f-zhuk/PatientMonitor/Electronics/PatientMonitor.csv

Source: | /home/fedorzhuk/Documents/KiCAD/PatientMonitor/PatientMonitor.kicad_sch
Date: | Du 26 mai 2024 01:57:51 +0300
Tool: | Eeschema 7.0.10-7.0.10~ubuntu20.04.1
Generator: | /usr/share/kicad/plugins/bom_csv_grouped_by_value_with_fp.py
Component Count: | 40
Ref | Qnty | Value | Cmp name | Footprint | Description | Vendor | DNP
BZ1 | 1 | Buzzer | Buzzer | Buzzer_Beeper:Buzzer_15x7.5RM7.6 | Buzzer, polarized
C1, C2, C3 | 3 | 10u | C | Capacitor_SMD:C_0805_2012Metric_Pad1.18x1.45mm_HandSolder | Unpolarized capacitor
C4, C5, C6, C7 | 4 | 100n | C | Capacitor_SMD:C_0603_1608Metric_Pad1.08x0.95mm_HandSolder | Unpolarized capacitor
H1, H2, H3, H4 | 4 | MountingHole | MountingHole | MountingHole:MountingHole_3.2mm_M3 | Mounting Hole without connection
J1, J6 | 2 | Conn_01x20 | Conn_01x20 | Connector_PinSocket_2.54mm:PinSocket_1x20_P2.54mm_Vertical | Generic connector, single row, 01x20, script generated (kicad-library-utils/schlib/autogen/connector/)
J2 | 1 | Conn_01x10 | Conn_01x10 | Connector_PinSocket_2.54mm:PinSocket_1x10_P2.54mm_Vertical | Generic connector, single row, 01x10, script generated (kicad-library-utils/schlib/autogen/connector/)
J3 | 1 | Conn_01x14 | Conn_01x14 | Connector_PinSocket_2.54mm:PinSocket_1x14_P2.54mm_Vertical | Generic connector, single row, 01x14, script generated (kicad-library-utils/schlib/autogen/connector/)
J4 | 1 | Conn_01x06 | Conn_01x06 | Connector_PinSocket_2.54mm:PinSocket_1x06_P2.54mm_Vertical | Generic connector, single row, 01x06, script generated (kicad-library-utils/schlib/autogen/connector/)
J5, J10 | 2 | Conn_01x03 | Conn_01x03 | Connector_PinSocket_2.54mm:PinSocket_1x03_P2.54mm_Vertical | Generic connector, single row, 01x03, script generated (kicad-library-utils/schlib/autogen/connector/)
J7, J8, J9 | 3 | Conn_01x01 | Conn_01x01 | Connector_Wire:SolderWire-0.5sqmm_1x01_D0.9mm_OD2.3mm | Generic connector, single row, 01x01, script generated (kicad-library-utils/schlib/autogen/connector/)
J11 | 1 | Conn_01x05 | Conn_01x05 | Connector_PinHeader_2.54mm:PinHeader_1x05_P2.54mm_Vertical | Generic connector, single row, 01x05, script generated (kicad-library-utils/schlib/autogen/connector/)
R1, R2, R3, R4, R7, R8, R12, R13, R14 | 9 | 10k | R | Resistor_SMD:R_0603_1608Metric_Pad0.98x0.95mm_HandSolder | Resistor
R5 | 1 | 2.2k | R | Resistor_SMD:R_0603_1608Metric_Pad0.98x0.95mm_HandSolder | Resistor
R6 | 1 | 68k | R | Resistor_SMD:R_0603_1608Metric_Pad0.98x0.95mm_HandSolder | Resistor
R9, R10 | 2 | 0R | R | Resistor_SMD:R_0603_1608Metric_Pad0.98x0.95mm_HandSolder | Resistor
R11 | 1 | 4.7k | R | Resistor_SMD:R_0603_1608Metric_Pad0.98x0.95mm_HandSolder | Resistor
U1 | 1 | TP4056 | TP4056 | Package_SO:SOIC-8-1EP_3.9x4.9mm_P1.27mm_EP2.29x3mm
U2 | 1 | LM1117DT-3.3 | LM1117DT-3.3 | Package_TO_SOT_SMD:TO-252-2 | 800mA Low-Dropout Linear Regulator, 3.3V fixed output, TO-252
U3 | 1 | 74HC14 | 74HC14 | Package_SO:SO-14_3.9x8.65mm_P1.27mm | Hex inverter schmitt trigger
