f-zhuk/PatientMonitor/Mechanical/Cover-AssemblyBody.stl

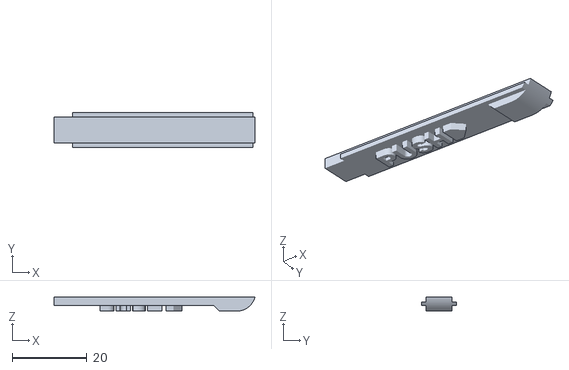
[picture p1: CAD file, 2024-06-10]
Mechanical/Cover-AssemblyBody.stl
53.9 x 9.50 x 3.80
