f-zhuk/PatientMonitor/Mechanical/Top-AssemblyBody.stl

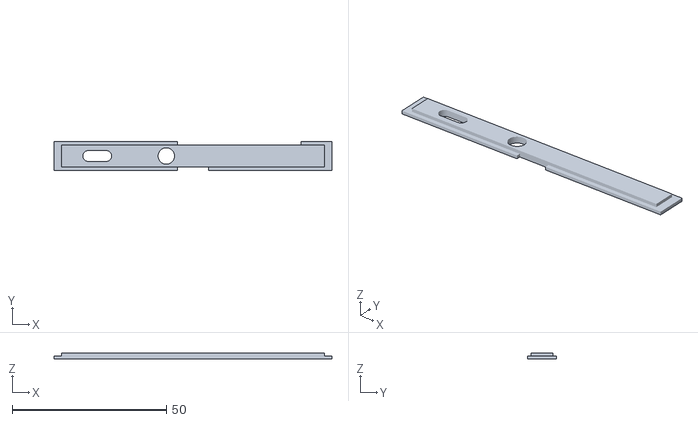
[picture p2: CAD file, 2024-06-10]
Mechanical/Top-AssemblyBody.stl
90.0 x 9.50 x 2.00
