f-zhuk/PatientMonitor/Mechanical/Bottom-AssemblyBody.stl

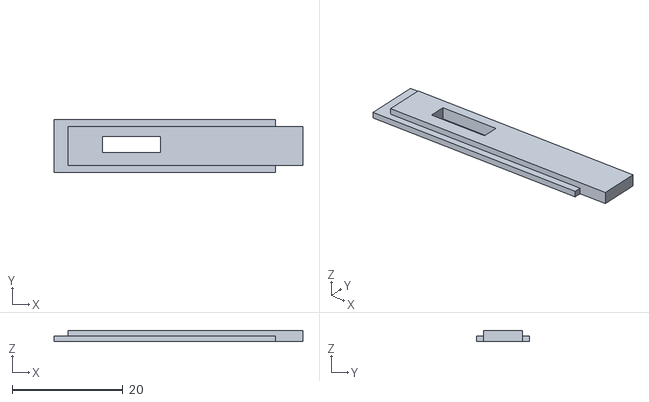
[picture p3: CAD file, 2024-06-10]
Mechanical/Bottom-AssemblyBody.stl
45.0 x 9.50 x 2.00
