f-zhuk/PatientMonitor/Mechanical/Panel_cut.FCStd

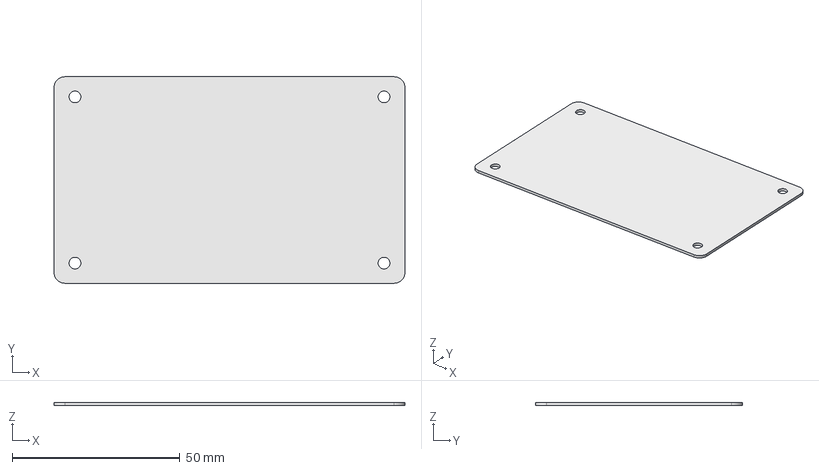
[picture p4: CAD file, 2024-06-10]
Mechanical/Panel_cut.FCStd
104.5 x 61.5 x 1.00 mm
