f-zhuk/PatientMonitor/Mechanical/Compartment-Part.3mf

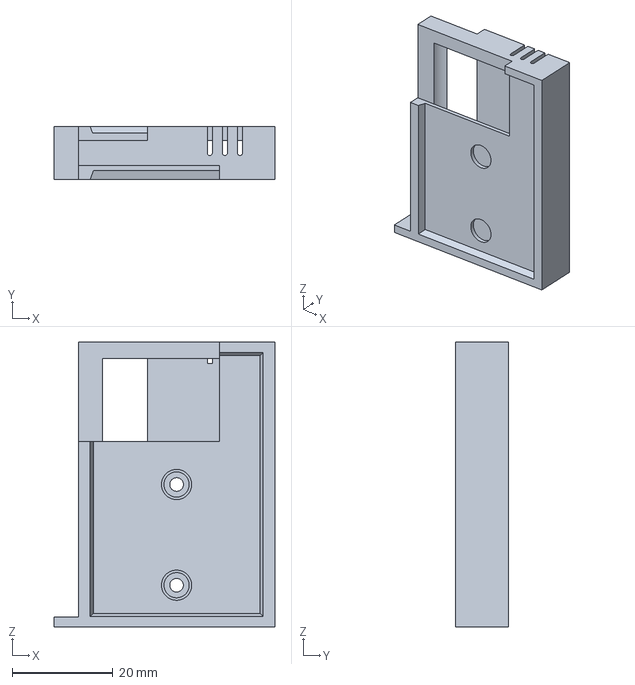
[picture p5: CAD file, 2024-06-10]
Mechanical/Compartment-Part.3mf
43.8 x 10.6 x 56.6 mm
