f-zhuk/PatientMonitor/Mechanical/Front-Front_Part.step

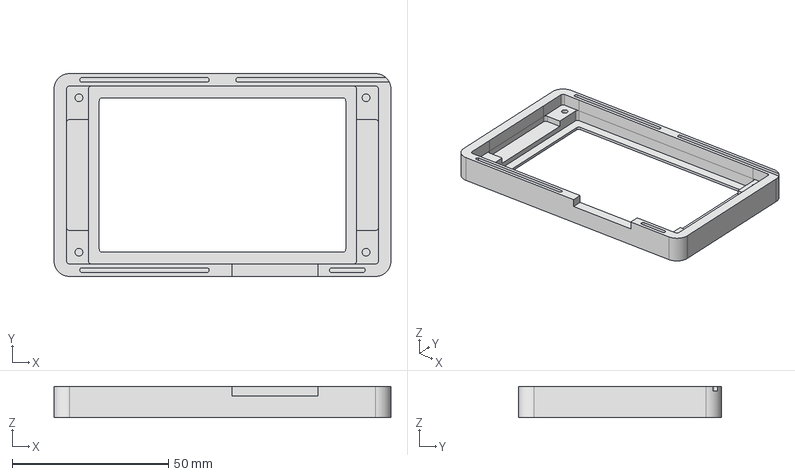
[picture p6: CAD file, 2024-06-10]
Mechanical/Front-Front_Part.step
108.0 x 65.0 x 10.0 mm
LCS_Origin
LCS_Top
LCS_Right
LCS_Cover
LCS_Bottom
