f-zhuk/PatientMonitor/Mechanical/Right-Right_Part.step

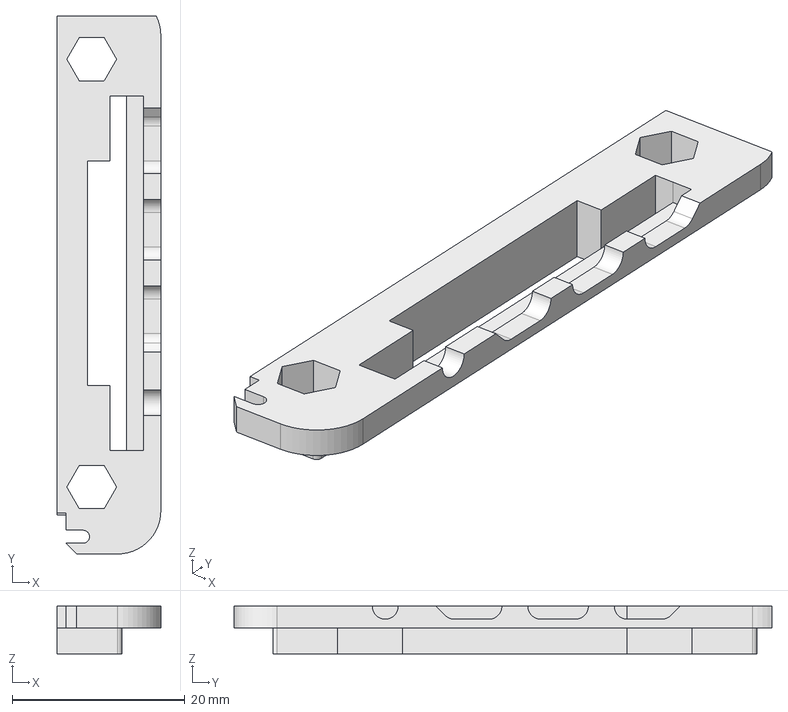
[picture p7: CAD file, 2024-06-10]
Mechanical/Right-Right_Part.step
12.0 x 62.2 x 5.50 mm
LCS_Origin
LCS_Front
