f-zhuk/PatientMonitor/Mechanical/AD8232_offset-AD8232_Part.stl

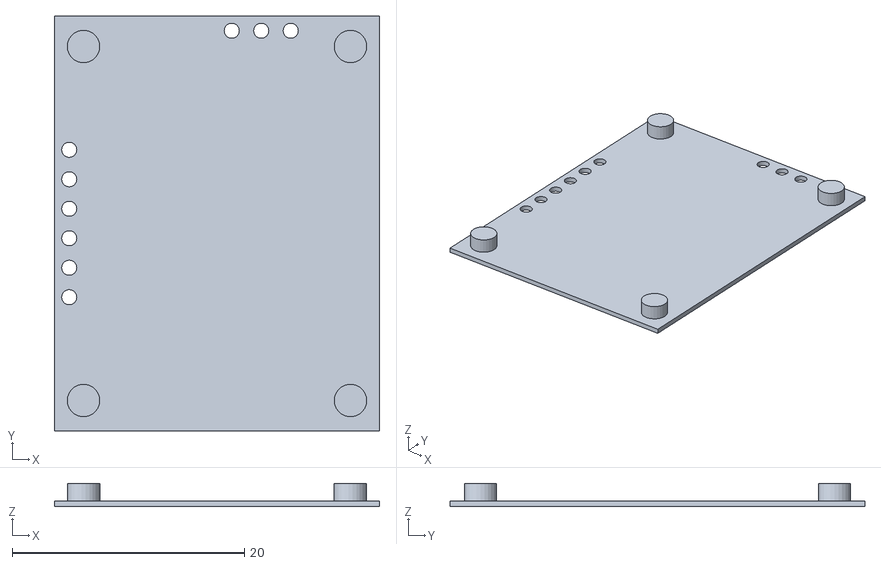
[picture p8: CAD file, 2024-06-10]
Mechanical/AD8232_offset-AD8232_Part.stl
28.0 x 35.8 x 2.00
