f-zhuk/PatientMonitor/Mechanical/BoardTest.FCStd

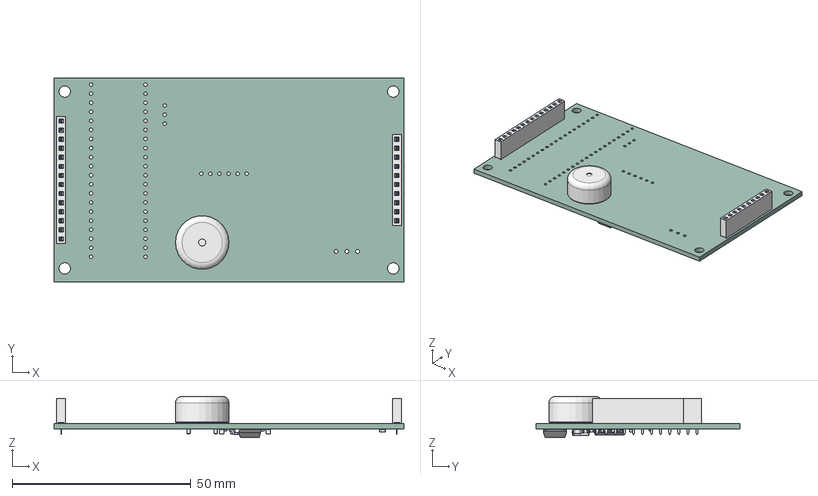
[picture p9: CAD file, 2024-06-10]
Mechanical/BoardTest.FCStd
98.0 x 57.0 x 11.6 mm
PinSocket_1x10_P254mm_Vertical
Buzzer_15x75RM76
PinSocket_1x14_P254mm_Vertical
R_0603_1608Metric
R_0603_1608Metric002
CQ assembly
CQ assembly001
CQ assembly002
CQ assembly003
CQ assembly004
CQ assembly005
CQ assembly006
CQ assembly007
CQ assembly008
CQ assembly009
CQ assembly010
CQ assembly011
CQ assembly012
CQ assembly013
CQ assembly014
CQ assembly015
R_0603_1608Metric004
C_0805_2012Metric
C_0603_1608Metric
R_0603_1608Metric006
C_0603_1608Metric002
SOIC_8_1EP_39x49mm_P127mm
CQ assembly017
CQ assembly018
CQ assembly019
CQ assembly020
CQ assembly021
R_0603_1608Metric008
C_0603_1608Metric004
C_0805_2012Metric002
R_0603_1608Metric010
R_0603_1608Metric012
C_0603_1608Metric006
C_0805_2012Metric004
R_0603_1608Metric014
PatientMonitor PCB
