f-zhuk/PatientMonitor/Mechanical/AD8232.FCStd

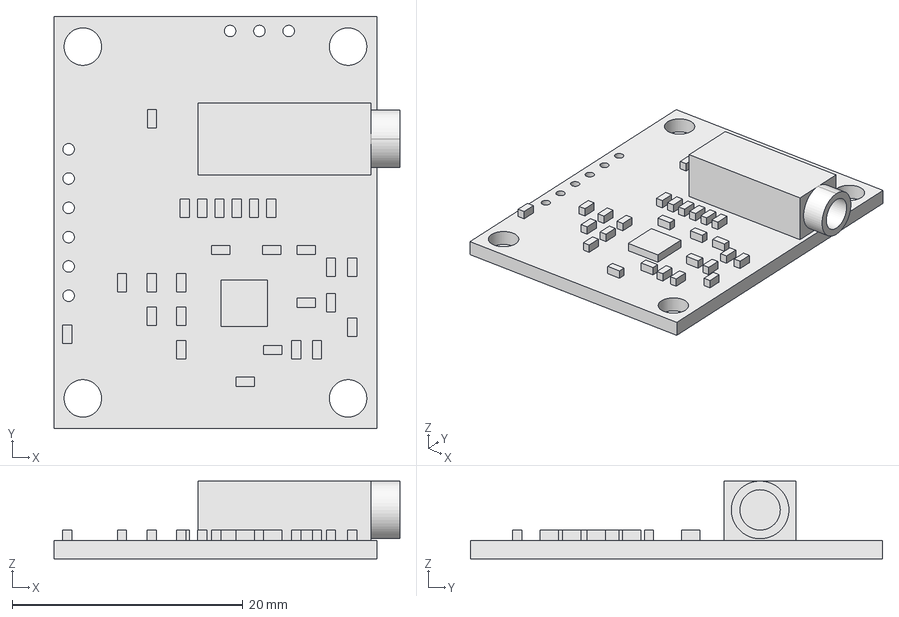
[picture p10: CAD file, 2024-06-10]
Mechanical/AD8232.FCStd
30.0 x 35.8 x 6.75 mm
