f-zhuk/PatientMonitor/Mechanical/FeetMold-Body.step

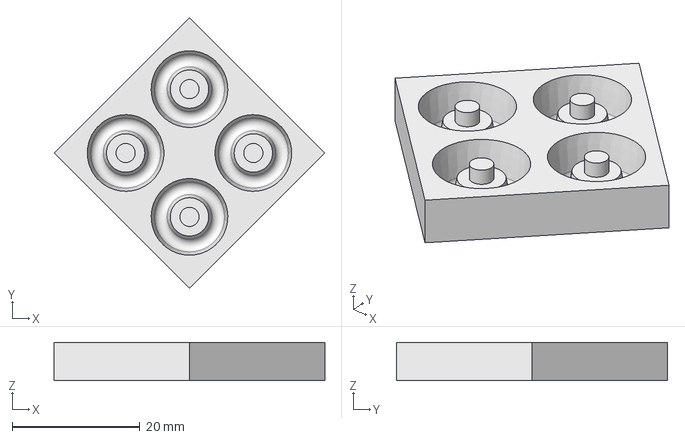
[picture p11: CAD file, 2024-06-10]
Mechanical/FeetMold-Body.step
42.4 x 42.4 x 6.00 mm
