f-zhuk/PatientMonitor/Mechanical/BLACKPILL.FCStd

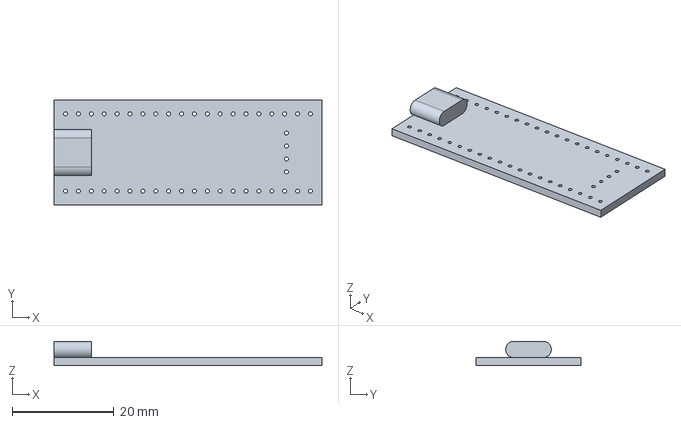
[picture p12: CAD file, 2024-06-10]
Mechanical/BLACKPILL.FCStd
52.8 x 20.8 x 4.80 mm
