f-zhuk/PatientMonitor/Mechanical/ButtonMold-Body2.step

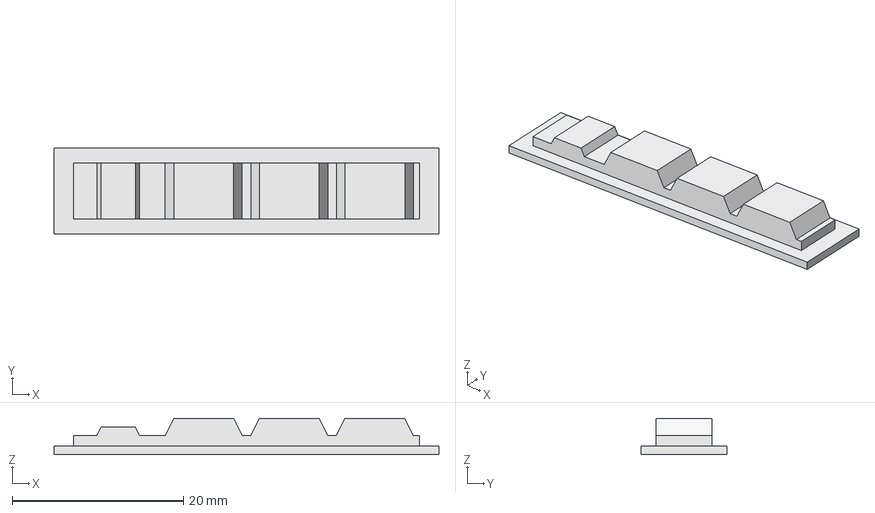
[picture p13: CAD file, 2024-06-10]
Mechanical/ButtonMold-Body2.step
45.0 x 10.0 x 4.25 mm
