f-zhuk/PatientMonitor/Mechanical/Back-Part.stl

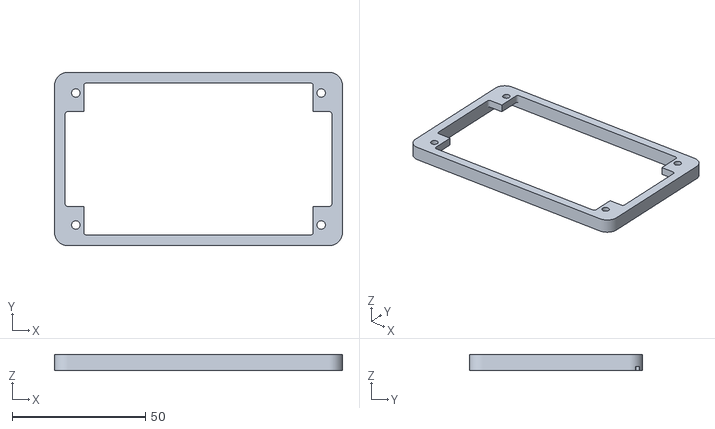
[picture p14: CAD file, 2024-06-10]
Mechanical/Back-Part.stl
108.0 x 65.0 x 6.00
