f-zhuk/PatientMonitor/Mechanical/Bezel.FCStd

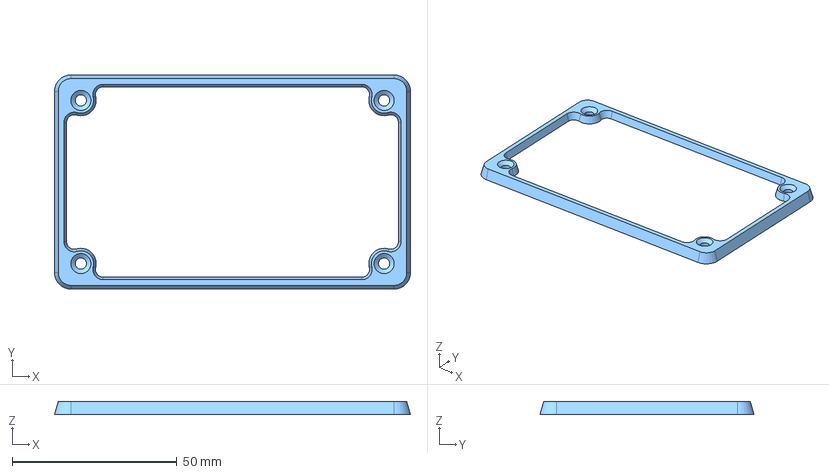
[picture p15: CAD file, 2024-06-10]
Mechanical/Bezel.FCStd
108.0 x 65.0 x 4.00 mm
