f-zhuk/PatientMonitor/Mechanical/ILI9488-Body.step

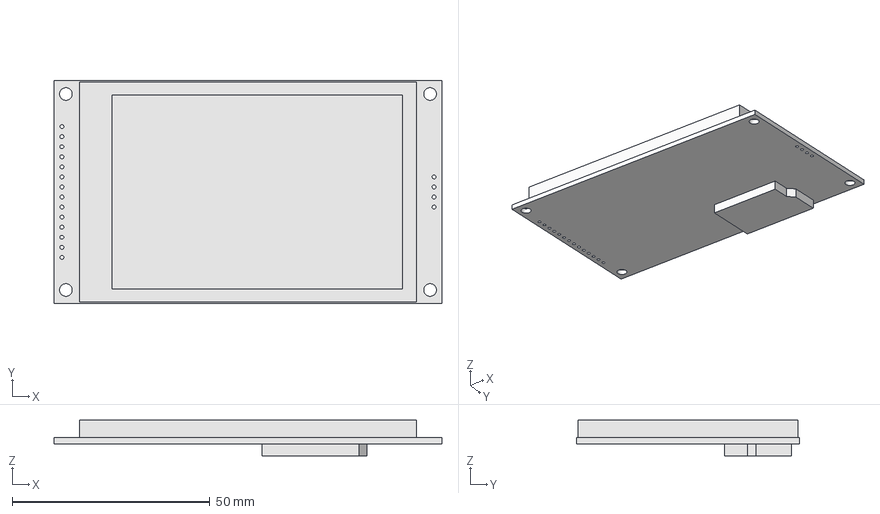
[picture p16: CAD file, 2024-06-10]
Mechanical/ILI9488-Body.step
98.0 x 56.3 x 9.00 mm
