f-zhuk/PatientMonitor/Mechanical/Right-Right_PartBody.step

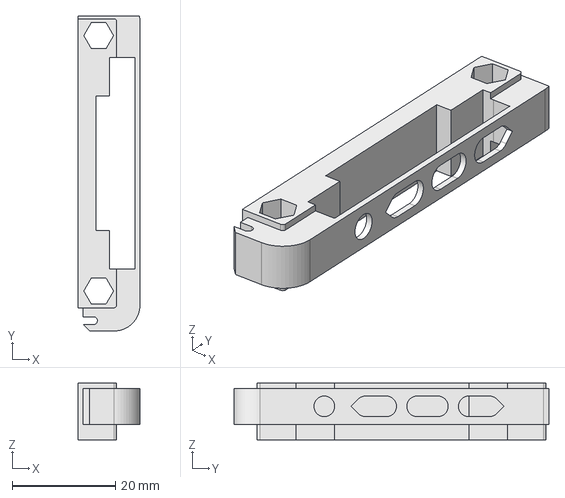
[picture p17: CAD file, 2024-06-10]
Mechanical/Right-Right_PartBody.step
12.0 x 61.0 x 11.0 mm
