f-zhuk/PatientMonitor/Mechanical/Cover-Cover_Part.step

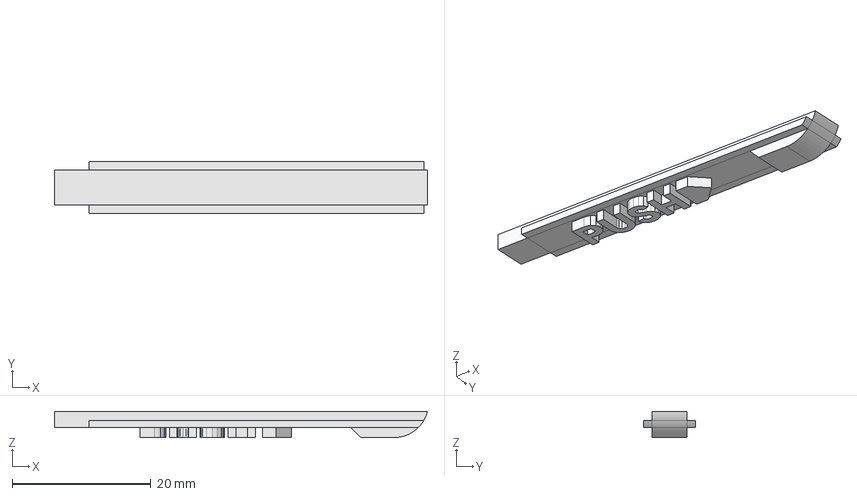
[picture p18: CAD file, 2024-06-10]
Mechanical/Cover-Cover_Part.step
53.9 x 7.50 x 3.80 mm
LCS_Origin
LCS_Front
