f-zhuk/PatientMonitor/Mechanical/Left_copart-Part.step

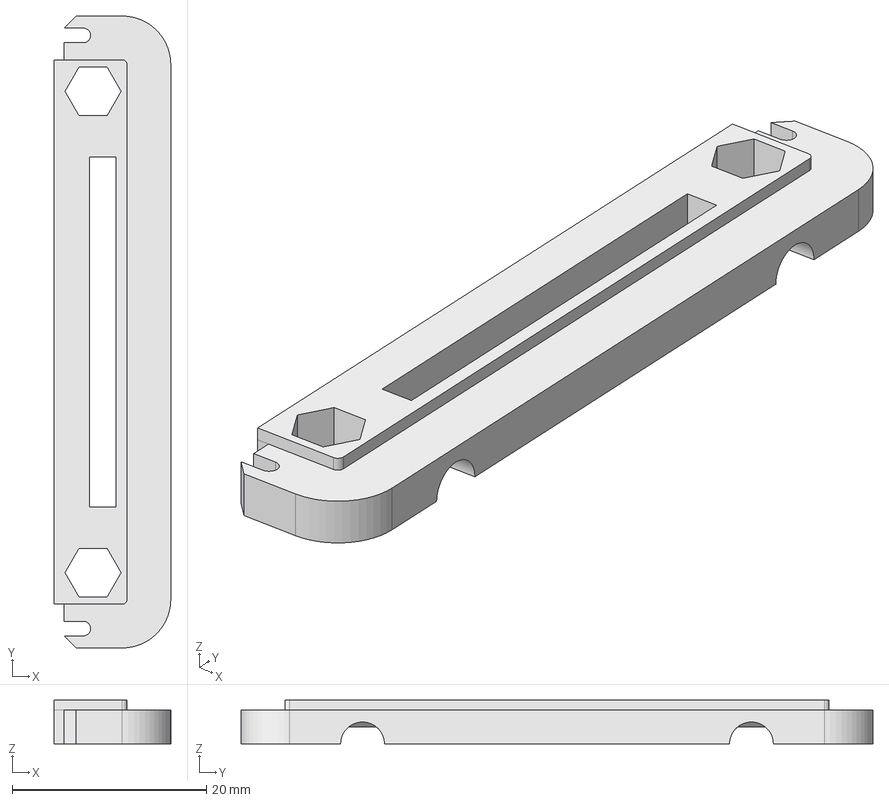
[picture p19: CAD file, 2024-06-10]
Mechanical/Left_copart-Part.step
12.0 x 65.0 x 4.50 mm
LCS_Origin
LCS_Front
