f-zhuk/PatientMonitor/Mechanical/Buzzer-Body.step

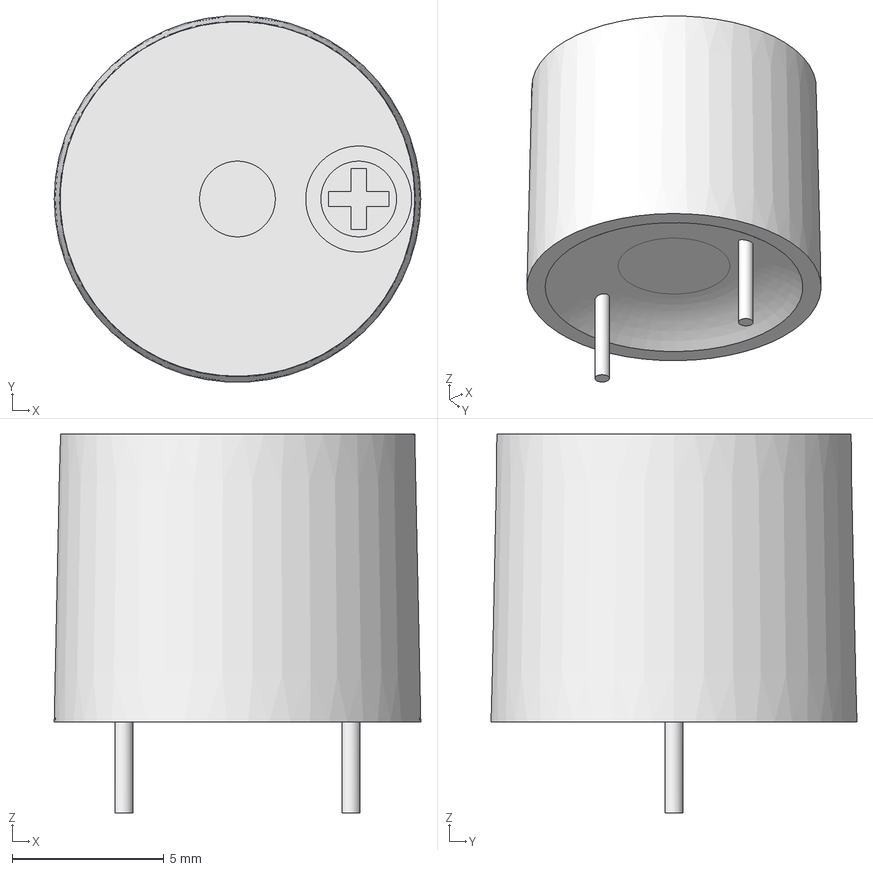
[picture p20: CAD file, 2024-06-10]
Mechanical/Buzzer-Body.step
12.1 x 12.1 x 12.5 mm
