f-zhuk/PatientMonitor/Mechanical/BL-4C.FCStd

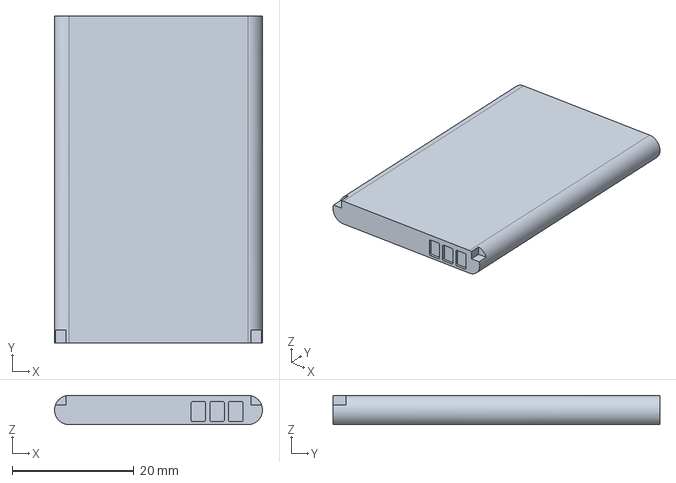
[picture p21: CAD file, 2024-06-10]
Mechanical/BL-4C.FCStd
34.1 x 53.6 x 4.80 mm
