f-zhuk/PatientMonitor/Mechanical/Left.FCStd

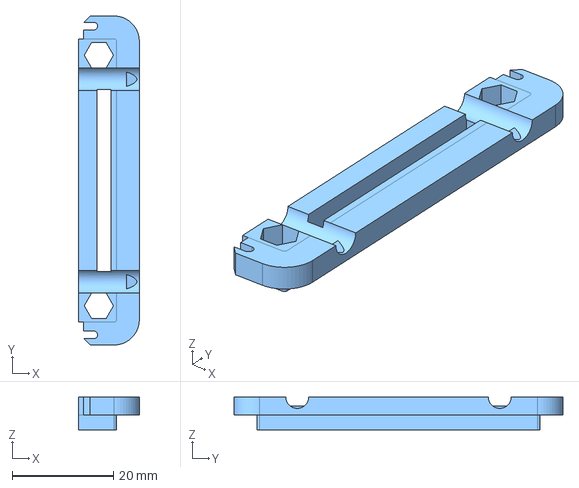
[picture p22: CAD file, 2024-06-10]
Mechanical/Left.FCStd
12.0 x 65.0 x 6.50 mm
