f-zhuk/PatientMonitor/Mechanical/ButtonMold.FCStd

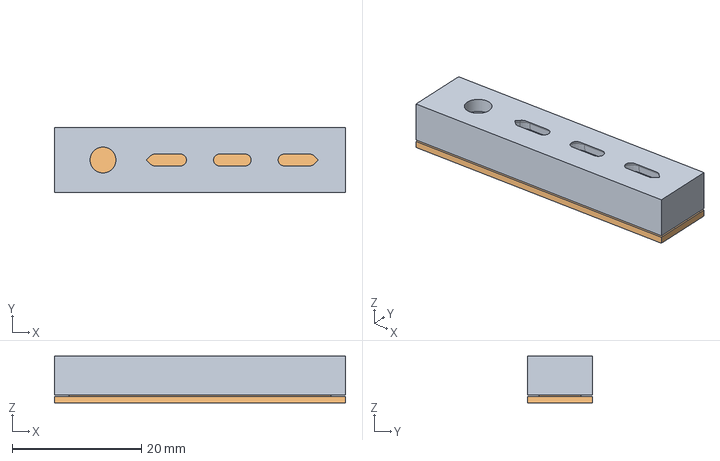
[picture p23: CAD file, 2024-06-10]
Mechanical/ButtonMold.FCStd
45.0 x 10.0 x 7.25 mm
