f-zhuk/PatientMonitor/Mechanical/PatientMonitor.FCStd

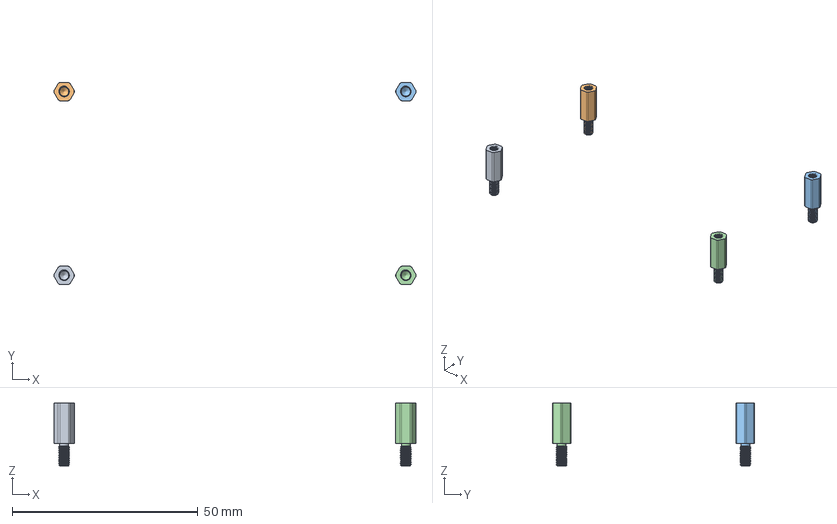
[picture p24: CAD file, 2024-06-10]
Mechanical/PatientMonitor.FCStd
97.5 x 54.5 x 16.9 mm
M3x11xx5-Standoff
M3x11xx5-Standoff013
M3x11xx5-Standoff014
M3x11xx5-Standoff015
