f-zhuk/PatientMonitor/Mechanical/PLS.FCStd

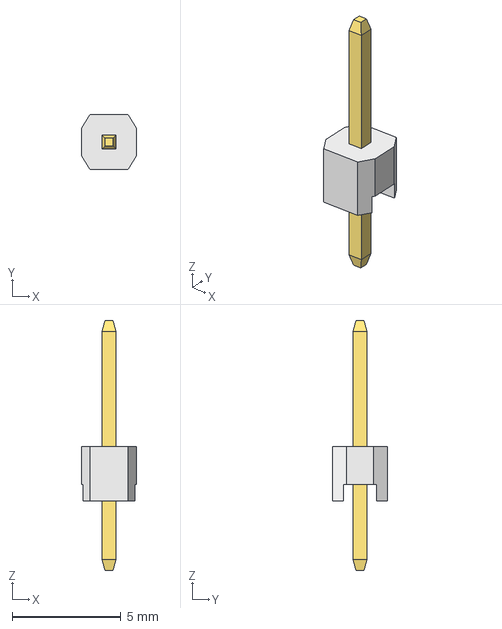
[picture p25: CAD file, 2024-06-10]
Mechanical/PLS.FCStd
2.54 x 2.54 x 11.5 mm
Pin
Skirt
