f-zhuk/PatientMonitor/Mechanical/ButtonMold-Body.step

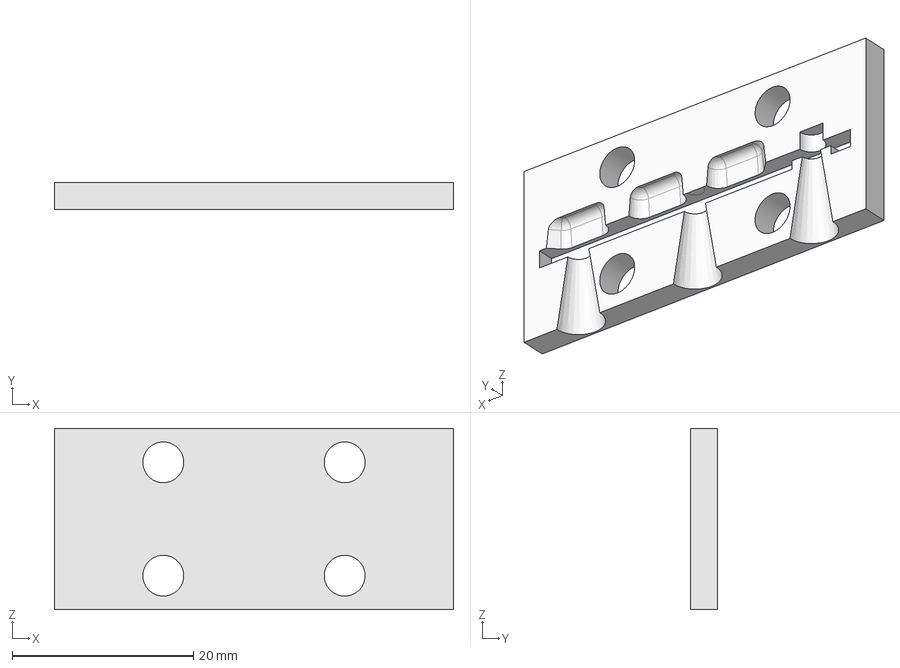
[picture p26: CAD file, 2024-06-10]
Mechanical/ButtonMold-Body.step
44.0 x 3.00 x 20.0 mm
