f-zhuk/PatientMonitor/Mechanical/TSW-101-07-G-S.stp

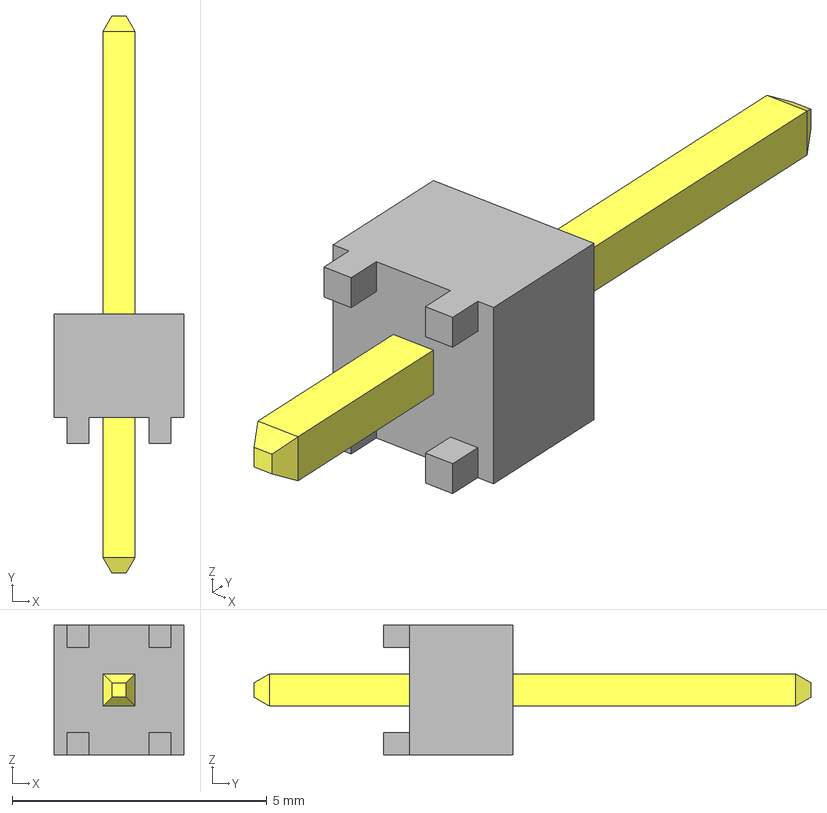
[picture p27: CAD file, 2024-06-10]
Mechanical/TSW-101-07-G-S.stp
2.54 x 10.9 x 2.54 mm
TSW-101-07-G-S_body
T-1S6-07-TSW-1-07-1-S
