f-zhuk/PatientMonitor/Mechanical/BLACKPILL_offset.FCStd

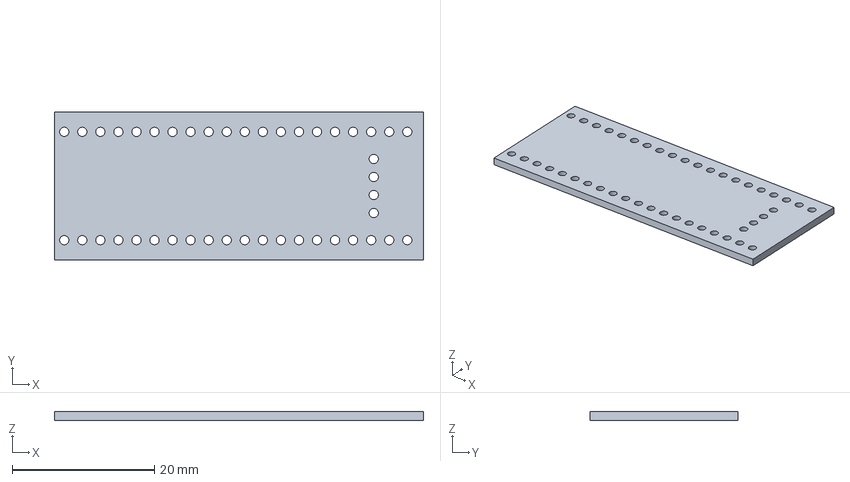
[picture p28: CAD file, 2024-06-10]
Mechanical/BLACKPILL_offset.FCStd
51.9 x 20.8 x 1.20 mm
