f-zhuk/PatientMonitor/(list of files, cad)

Other CAD files:
Mechanical/FeetMold-BodySketch.step
Mechanical/Panel.FCStd
Mechanical/Cover.FCStd
Mechanical/Bottom.FCStd
Mechanical/Back_cut.FCStd
Mechanical/Top.FCStd
Mechanical/Front_cut.FCStd
Mechanical/FeetMold.FCStd
Mechanical/Front.FCStd
Mechanical/AD8232_offset.FCStd
Mechanical/Bezel-Part.stl
Mechanical/Back.FCStd
Mechanical/Buzzer.FCStd
Mechanical/AD8232-Body.step
Mechanical/Right.FCStd
Mechanical/Left-Part.step
Mechanical/Compartment.FCStd
Mechanical/Left_copart.FCStd
Mechanical/Bezel-PartSketch.step
Mechanical/ILI9488.FCStd
Mechanical/AD8232-Body.stl
Mechanical/Bezel-PartSketch.stl
Mechanical/Compartment-Part.stl
Mechanical/Front-Front_Part.stl
Mechanical/ILI9488-Body.stl
Mechanical/Left-Part.stl
Mechanical/Left_copart-Part.stl
