f-zhuk/PatientMonitor/Electronics/PatientMonitor.pdf

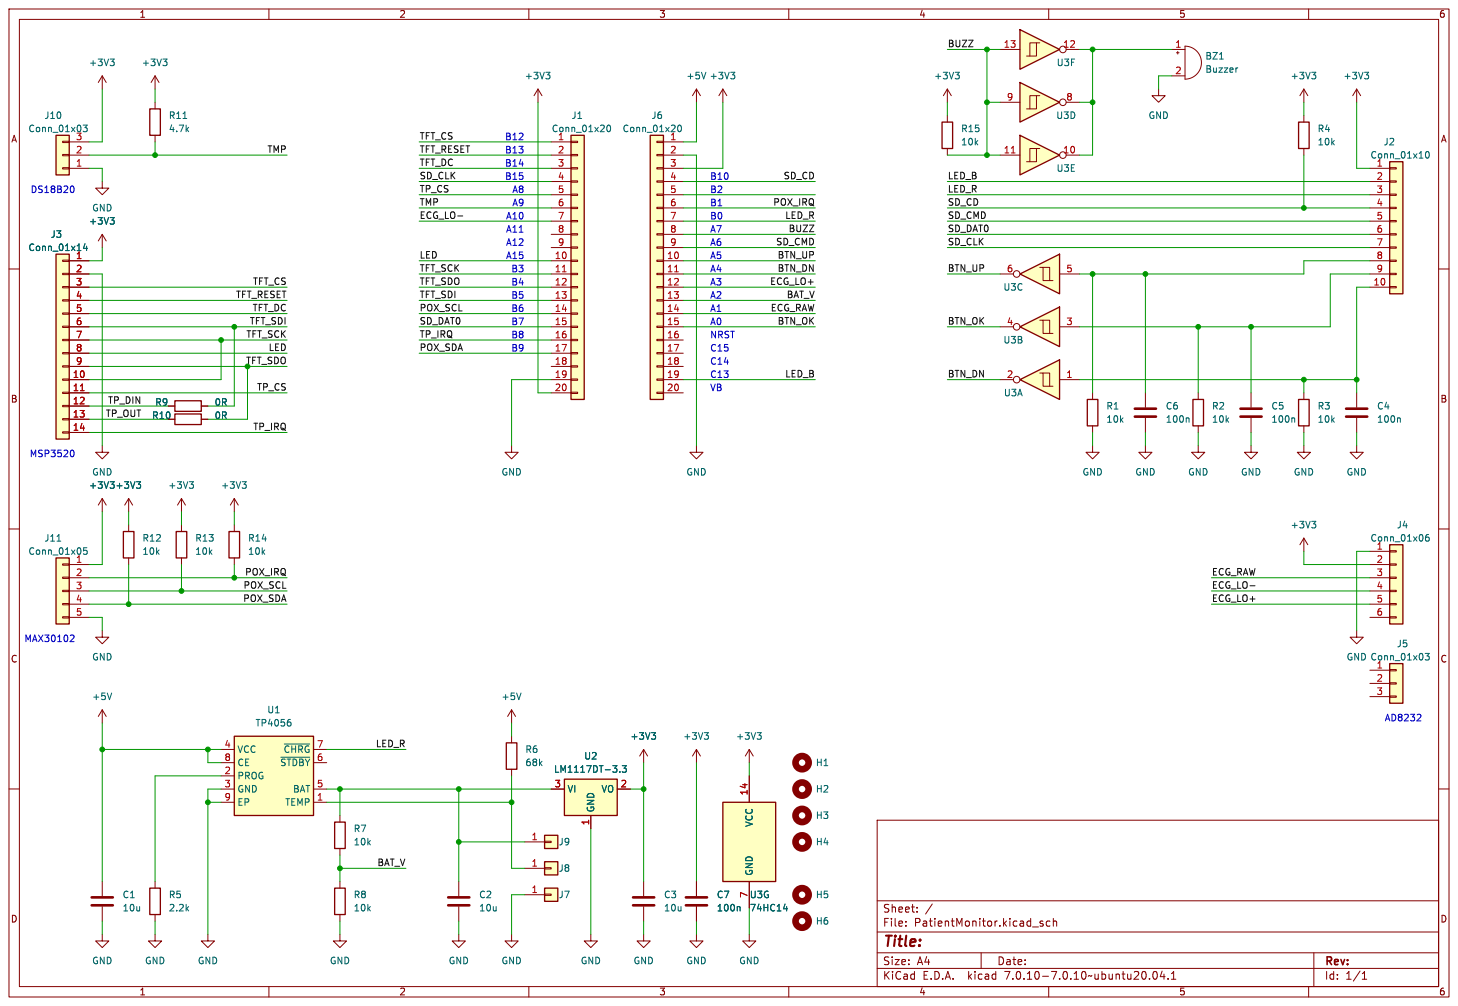
[picture p29: page 1]

Id: 1/1 Title: File: PatientMonitor.kicad_sch Sheet: /
