f-zhuk/PatientMonitor/Electronics/ButtonBreakout/PatientMonitorButtons/PatientMonitorButtons.pdf

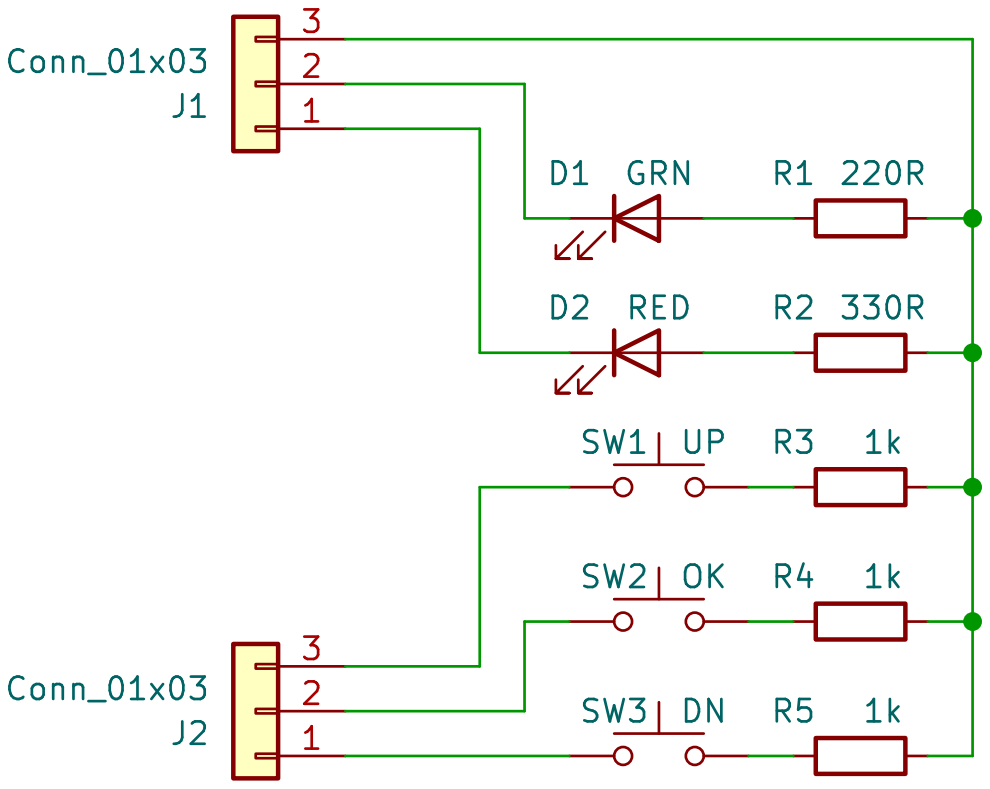
[picture p30: page 1]

Id: 1/1 Title: File: PatientMonitorButtons.kicad_sch Sheet: /
