f-zhuk/PatientMonitor/Electronics/PatientMonitor-B_Cu.pdf

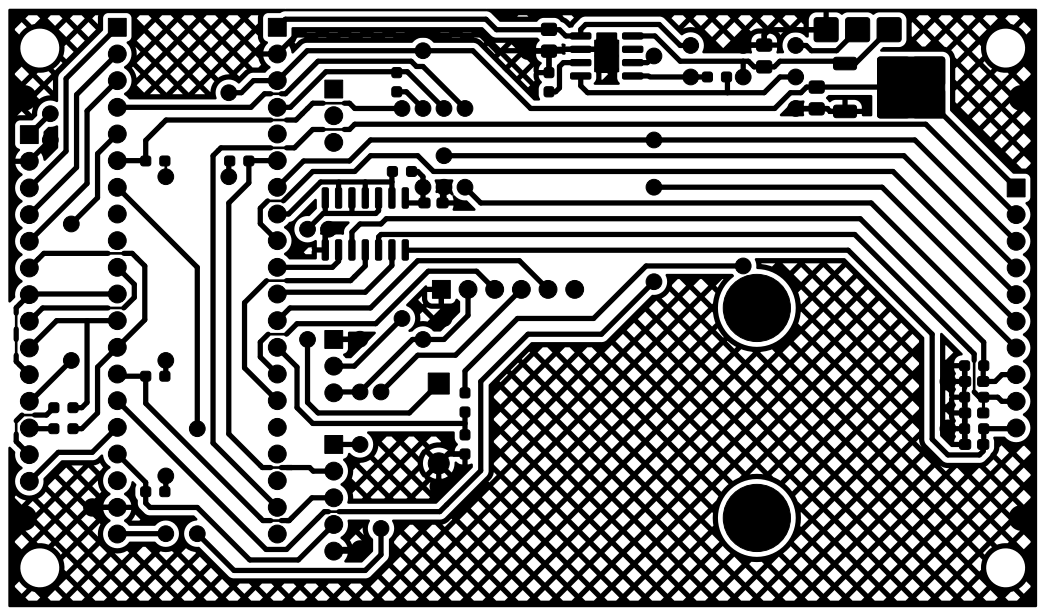
[picture p31: page 1]
