f-zhuk/PatientMonitor/Electronics/PatientMonitor-F_Cu.pdf

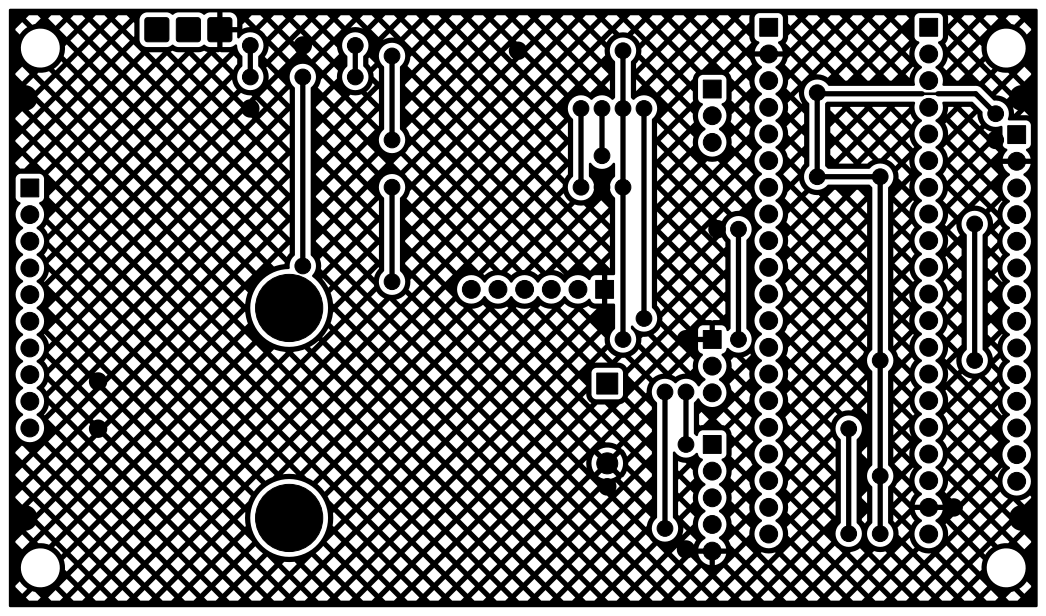
[picture p32: page 1]
