f-zhuk/PatientMonitor/Electronics/PatientMonitor.kicad_pcb

## KiCad design Electronics/PatientMonitor.kicad_pcb (2024-06-10)

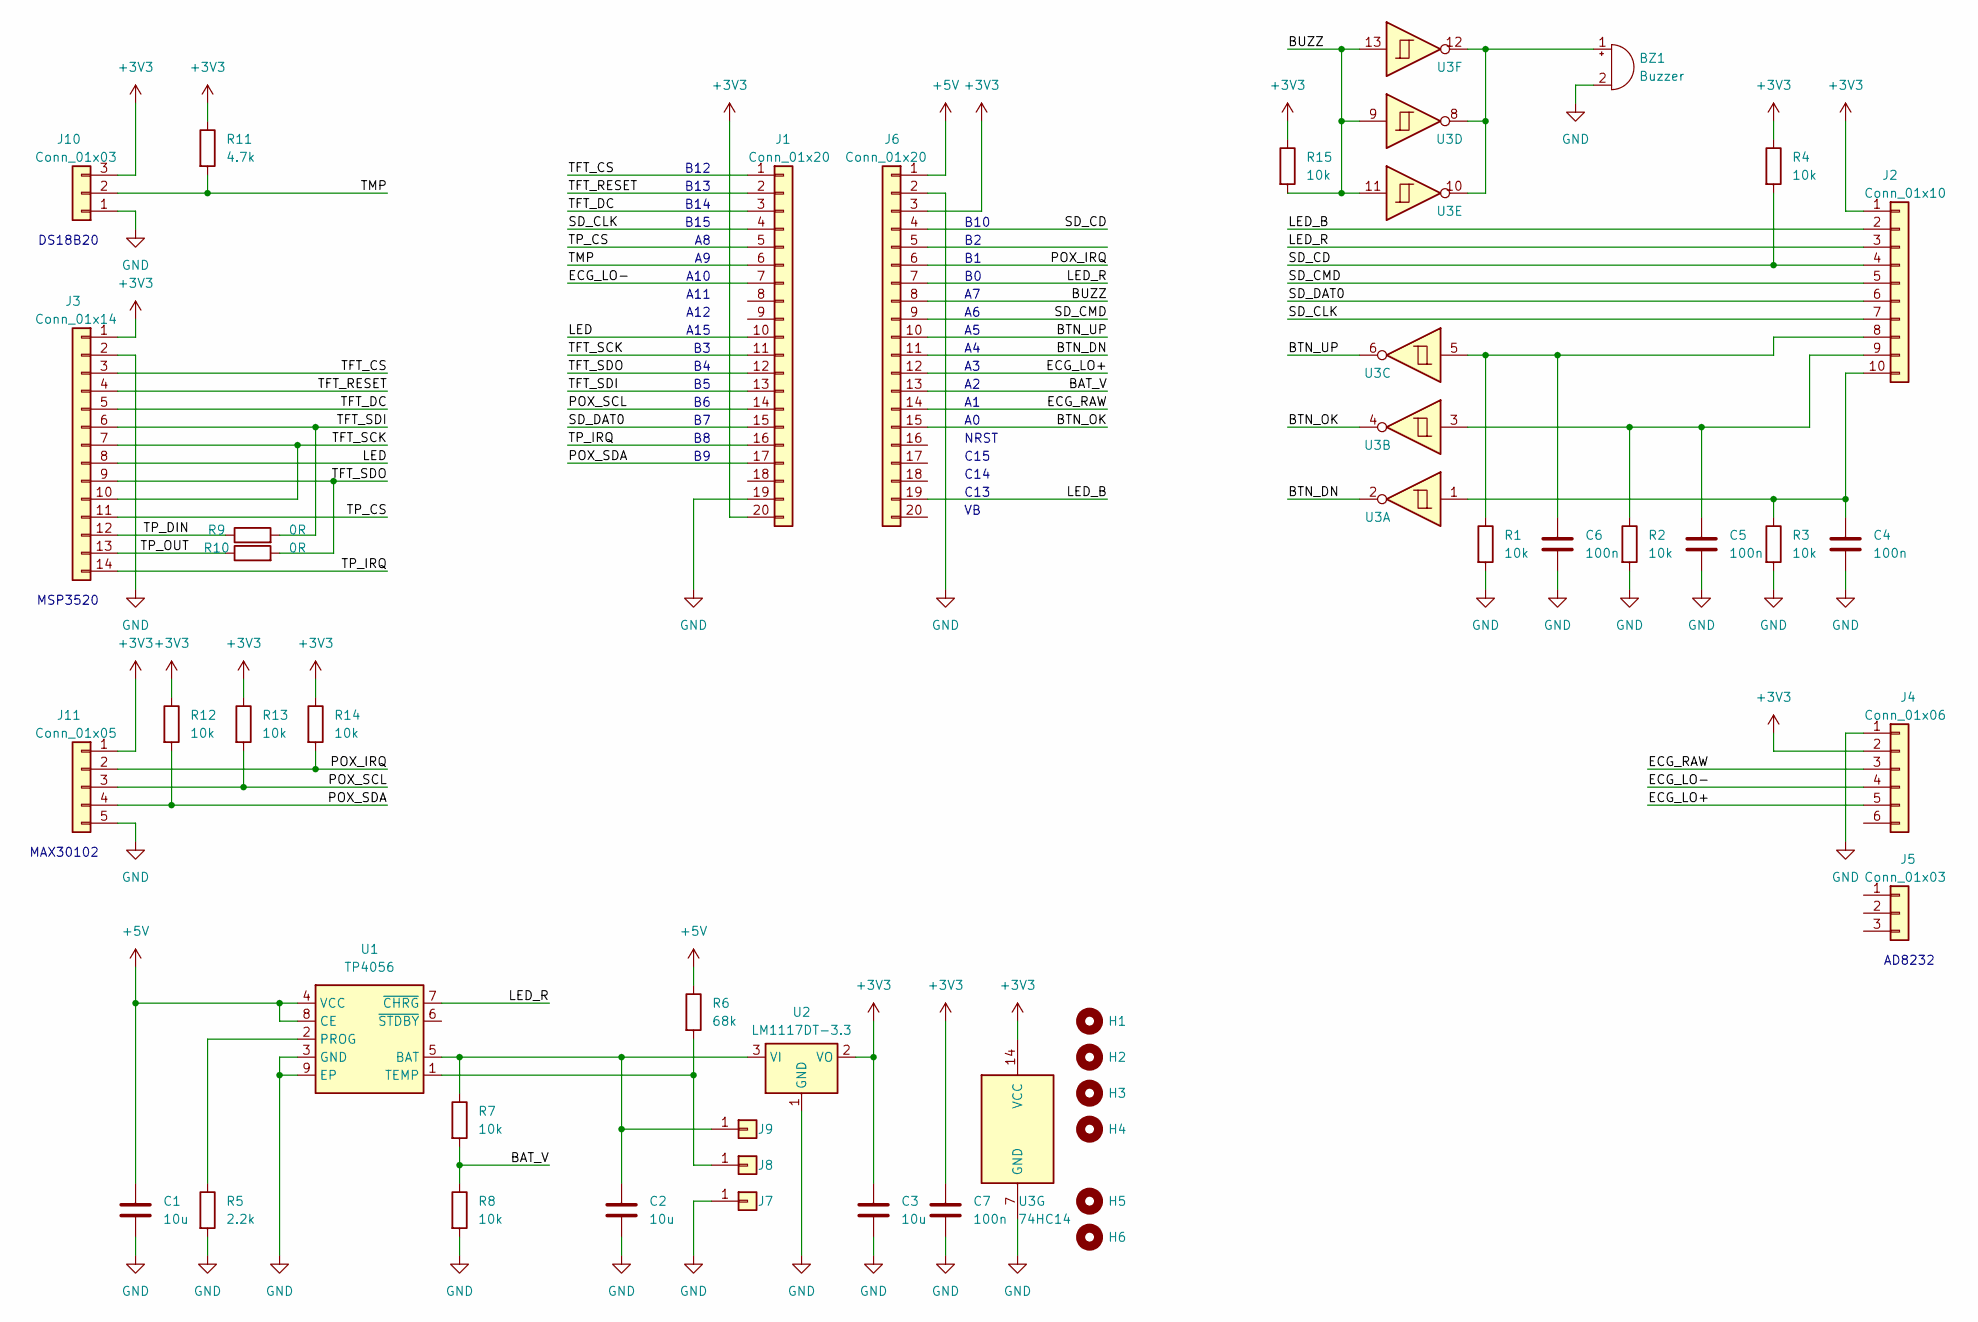
[picture p33: schematic PatientMonitor.kicad_sch]

Parts:
BZ1: Buzzer; Buzzer_15x7.5RM7.6
C1, C2, C3: 10u; C_0805_2012Metric_Pad1.18x1.45mm_HandSolder
C4, C5, C6, C7: 100n; C_0603_1608Metric_Pad1.08x0.95mm_HandSolder
H1, H2, H3, H4: MountingHole; MountingHole_3.2mm_M3
H5, H6: MountingHole; MountingHole_3.2mm_M3_Pad
J1, J6: Conn_01x20; PinSocket_1x20_P2.54mm_Vertical
J2: Conn_01x10; PinSocket_1x10_P2.54mm_Vertical
J3: Conn_01x14; PinSocket_1x14_P2.54mm_Vertical
J4: Conn_01x06; PinSocket_1x06_P2.54mm_Vertical
J5, J10: Conn_01x03; PinSocket_1x03_P2.54mm_Vertical
J7, J8, J9: Conn_01x01; SolderWire-0.5sqmm_1x01_D0.9mm_OD2.3mm
J11: Conn_01x05; PinHeader_1x05_P2.54mm_Vertical
R1, R2, R3, R4, R7, R8, R12, R13, R14, R15: 10k; R_0603_1608Metric_Pad0.98x0.95mm_HandSolder
R5: 2.2k; R_0603_1608Metric_Pad0.98x0.95mm_HandSolder
R6: 68k; R_0603_1608Metric_Pad0.98x0.95mm_HandSolder
R9, R10: 0R; R_0603_1608Metric_Pad0.98x0.95mm_HandSolder
R11: 4.7k; R_0603_1608Metric_Pad0.98x0.95mm_HandSolder
U1: TP4056; SOIC-8-1EP_3.9x4.9mm_P1.27mm_EP2.29x3mm
U2: LM1117DT-3.3; TO-252-2
U3: 74HC14; SO-14_3.9x8.65mm_P1.27mm

Connections:
+3V3: C3.1, C7.1, J1.20, J2.1, J3.1, J4.2, J6.3, J10.3, J11.1, R4.1, R11.1, R12.1, R13.1, R14.1, R15.1, U2.2 (VO), U3.14 (VCC)
+5V: C1.1, J6.1, R6.1, U1.4 (VCC), U1.8 (CE)
/BAT_V: J6.13, R7.2, R8.1
/BTN_DN: J6.11, U3.2
/BTN_OK: J6.15, U3.4
/BTN_UP: J6.10, U3.6
/BUZZ: J6.8, R15.2, U3.9, U3.11, U3.13
/ECG_LO+: J4.5, J6.12
/ECG_LO-: J1.7, J4.4
/ECG_RAW: J4.3, J6.14
/LED: J1.10, J3.8
/LED_B: J2.2, J6.19
/LED_R: J2.3, J6.7, U1.7 (~CHRG)
/POX_IRQ: J6.6, J11.2, R14.2
/POX_SCL: J1.14, J11.3, R13.2
/POX_SDA: J1.17, J11.4, R12.2
/SD_CD: J2.4, J6.4, R4.2
/SD_CLK: J1.4, J2.7
/SD_CMD: J2.5, J6.9
/SD_DAT0: J1.15, J2.6
/TFT_CS: J1.1, J3.3
/TFT_DC: J1.3, J3.5
/TFT_RESET: J1.2, J3.4
/TFT_SCK: J1.11, J3.7, J3.10
/TFT_SDI: J1.13, J3.6, R9.2
/TFT_SDO: J1.12, J3.9, R10.2
/TMP: J1.6, J10.2, R11.2
/TP_CS: J1.5, J3.11
/TP_DIN: J3.12, R9.1
/TP_IRQ: J1.16, J3.14
/TP_OUT: J3.13, R10.1
GND: BZ1.2 (-), C1.2, C2.2, C3.2, C4.2, C5.2, C6.2, C7.2, J1.19, J3.2, J4.1, J6.2, J7.1, J10.1, J11.5, R1.2, R2.2, R3.2, R5.2, R8.2, U1.3 (GND), U1.9 (EP), U2.1 (GND), U3.7 (GND)
unnamed: BZ1.1 (+), U3.8, U3.10, U3.12
unnamed: C6.1, J2.8, R1.1, U3.5
unnamed: C5.1, J2.9, R2.1, U3.3
unnamed: C4.1, J2.10, R3.1, U3.1
unnamed: J8.1, R6.2, U1.1 (TEMP)
unnamed: C2.1, J9.1, R7.1, U1.5 (BAT), U2.3 (VI)
unnamed: R5.1, U1.2 (PROG)

Notes on the sheet:
B15
A11
MSP3520
A12
AD8232
B13
B14
MAX30102
NRST
C13
C15
B10
B12
A15
A10
DS18B20
C14

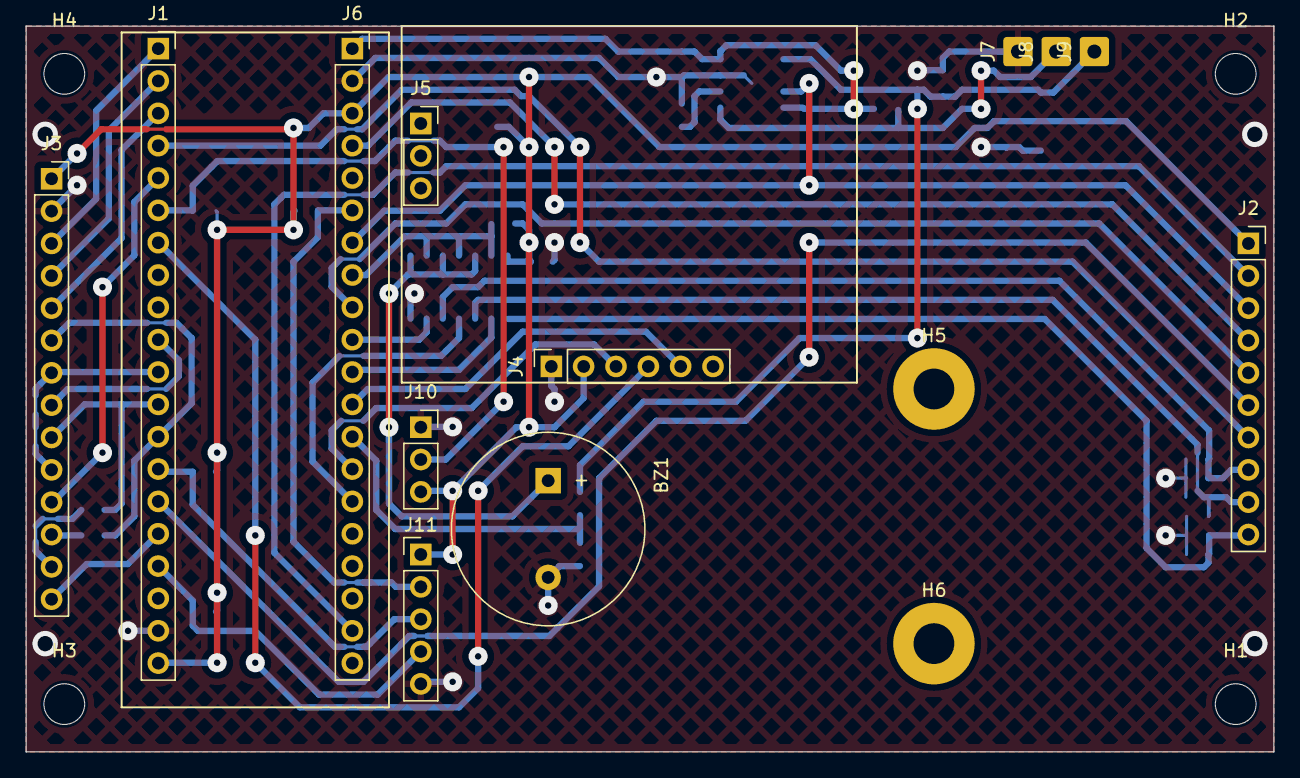
[picture p34: board PatientMonitor.kicad_pcb from above]

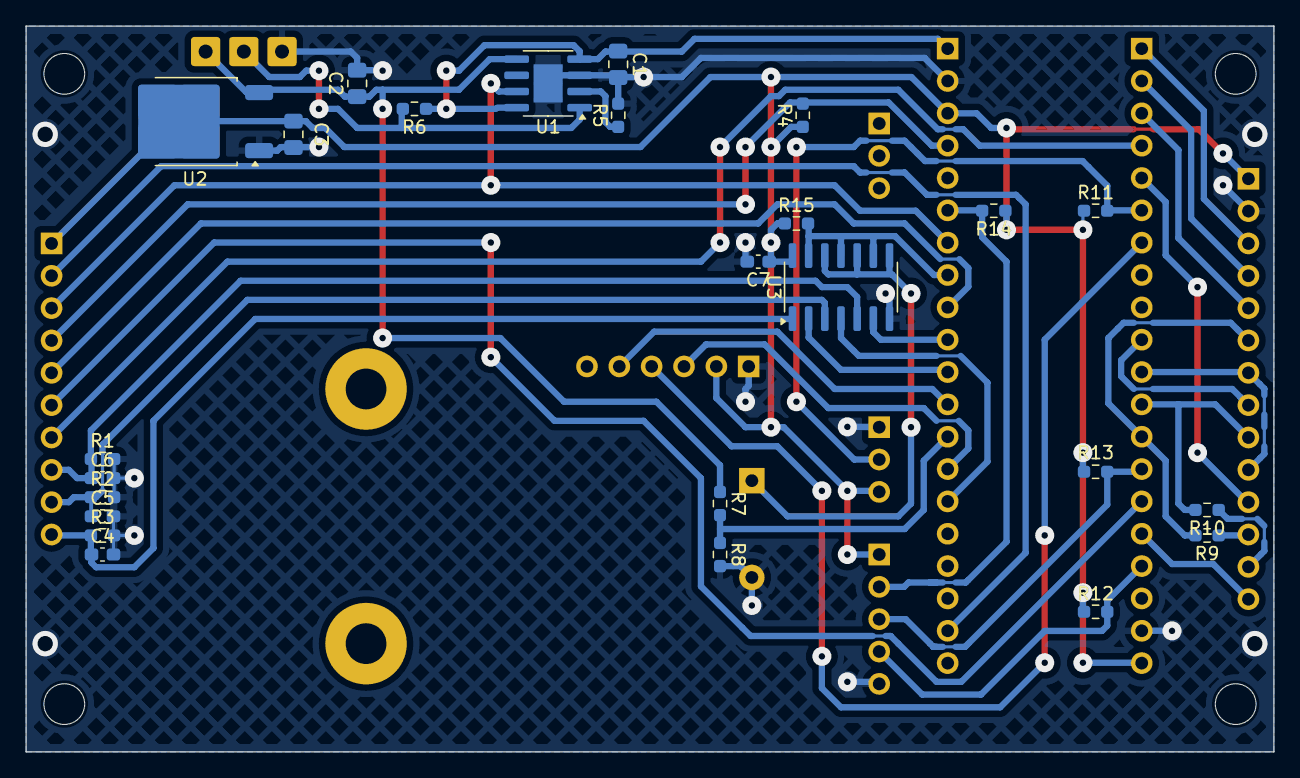
[picture p35: board PatientMonitor.kicad_pcb from below]

Board: 2 copper layers, 98.0 x 57.0 mm, 43 parts (25 on the bottom side), 39 nets.
