f-zhuk/PatientMonitor/Electronics/ButtonBreakout/PatientMonitorButtons/PatientMonitorButtons.kicad_pcb

## KiCad design Electronics/ButtonBreakout/PatientMonitorButtons/PatientMonitorButtons.kicad_pcb (2024-06-10)

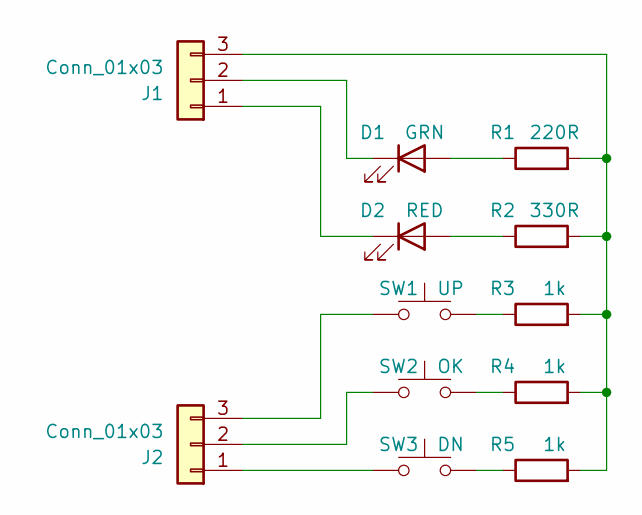
[picture p36: schematic PatientMonitorButtons.kicad_sch]

Parts:
D1: GRN; LED_0805_2012Metric_Pad1.15x1.40mm_HandSolder
D2: RED; LED_0805_2012Metric_Pad1.15x1.40mm_HandSolder
J1, J2: Conn_01x03; PinHeader_1x03_P2.54mm_Horizontal
R1: 220R; R_0603_1608Metric_Pad0.98x0.95mm_HandSolder
R2: 330R; R_0603_1608Metric_Pad0.98x0.95mm_HandSolder
R3, R4, R5: 1k; R_0603_1608Metric_Pad0.98x0.95mm_HandSolder
SW1: UP; SW_SPST_CK_PTS641
SW2: OK; SW_SPST_CK_PTS641
SW3: DN; SW_SPST_CK_PTS641

Connections:
unnamed: D1.2 (A), R1.1
unnamed: D1.1 (K), J1.2
unnamed: D2.2 (A), R2.1
unnamed: D2.1 (K), J1.1
unnamed: J1.3, R1.2, R2.2, R3.2, R4.2, R5.2
unnamed: J2.1, SW3.1
unnamed: J2.2, SW2.1
unnamed: J2.3, SW1.1
unnamed: R3.1, SW1.2
unnamed: R4.1, SW2.2
unnamed: R5.1, SW3.2

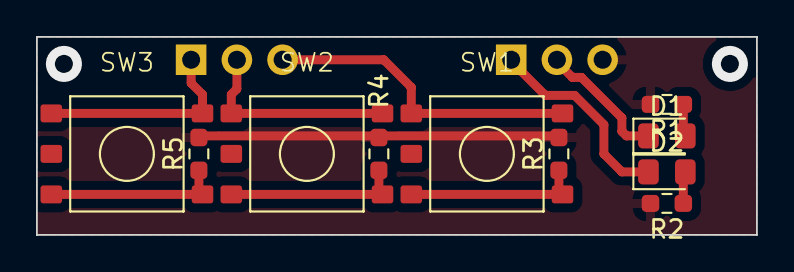
[picture p37: board PatientMonitorButtons.kicad_pcb from above]

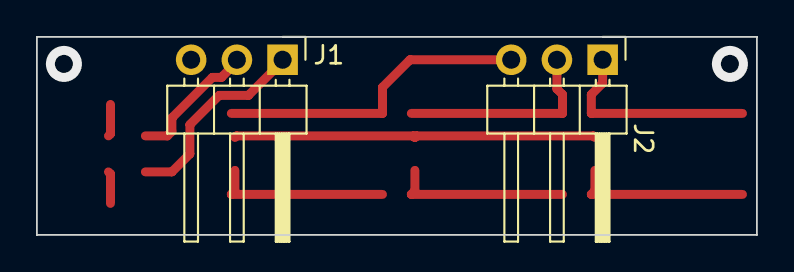
[picture p38: board PatientMonitorButtons.kicad_pcb from below]

Board: 2 copper layers, 40.0 x 11.0 mm, 12 parts (2 on the bottom side), 11 nets.
