f-zhuk/PatientMonitor/Firmware/STM32F11_ILI9488.ioc

Mcu.UserName=STM32F411CEUx
PA0-WKUP.GPIO_Label=BTN_OK
PA0-WKUP.Signal=SYS_WKUP
PA1.GPIO_Label=ECG_RAW
PA1.Signal=ADCx_IN1
PA10.GPIO_Label=LON
PA10.Signal=GPIO_Input
PA11.Signal=USB_OTG_FS_DM
PA12.Signal=USB_OTG_FS_DP
PA13.Signal=SYS_JTMS-SWDIO
PA14.Signal=SYS_JTCK-SWCLK
PA15.GPIO_Label=LED
PA15.Signal=S_TIM2_CH1_ETR
PA2.GPIO_Label=BAT_V
PA2.Signal=ADCx_IN2
PA3.GPIO_Label=LOP
PA3.Signal=GPIO_Input
PA4.GPIO_Label=BTN_DN
PA4.Signal=GPIO_Input
PA5.GPIO_Label=BTN_UP
PA5.Signal=GPIO_Input
PA6.Signal=SDIO_CMD
PA7.GPIO_Label=BUZZ
PA7.Signal=S_TIM3_CH2
PA8.GPIO_Label=TP_CS
PA8.Signal=GPIO_Output
PA9.GPIO_Label=TMP
PA9.Signal=USART1_TX
PB0.GPIO_Label=LED_R
PB0.Signal=GPIO_Input
PB1.GPIO_Label=POX_IRQ
PB1.Signal=GPXTI1
PB10.GPIO_Label=SD_CD
PB10.Signal=GPIO_Input
PB12.GPIO_Label=TFT_CS
PB12.Signal=GPIO_Output
PB13.GPIO_Label=TFT_RST
PB13.Signal=GPIO_Output
PB14.GPIO_Label=TFT_DC
PB14.Signal=GPIO_Output
PB15.Signal=SDIO_CK
PB3.Signal=SPI1_SCK
PB4.Signal=SPI1_MISO
PB5.Signal=SPI1_MOSI
PB6.Signal=I2C1_SCL
PB7.Signal=SDIO_D0
PB8.GPIO_Label=TP_IRQ
PB8.Signal=GPXTI8
PB9.Signal=I2C1_SDA
PC13-ANTI_TAMP.GPIO_Label=LED_B
PC13-ANTI_TAMP.Signal=GPIO_Output
PC14-OSC32_IN.Signal=RCC_OSC32_IN
PC15-OSC32_OUT.Signal=RCC_OSC32_OUT
