f-zhuk/PatientMonitor/(commit log)

2024-06-10 Initial upload for history
    [AD8232-Body.step, AD8232-Body.stl, AD8232.FCStd, AD8232_offset-AD8232_Part.stl, AD8232_offset.FCStd, BL-4C.FCStd, BLACKPILL.FCStd, BLACKPILL_offset.FCStd]
2024-06-11 Visuals and STM32CUBE config added
