f-zhuk/PatientMonitor/(notices)

Notices in the files:
Mechanical/TSW-101-07-G-S.stp:
author */ ('License CC BY-ND 4.0'),
